Hootie81/Dual-DC-Motor/Dual DC Motor v1-0/DualDCMotor v1-0 BOM.xlsx

Hootie81's Dual DC Motor Controller Shield
Version 1.0
2014-08-02
Description | Qty | Value | Package | Designator | Manufacturer | Part Number
PCB | 1 | V1.0 | NA | NA | OSH Park | NA
IC Motor Driver | 1 | NA | 24-SSOP | U1 | Toshiba | TB6612FNG(O,C,8,EL)
SPI I/O Expander PWM | 1 | NA | 16-SSOP | U2 | Maxim | MAX6966AEE+
Capacitor Tantalum | 1 | 10uF 25v 10% | 1411 | C3 | Kemet | T491B106K025AT
Capacitor | 2 | 0.1uF 25v 10% | 603 | C1, C2 | Murata | GRM188R71E104KA01D
Resistor | 7 | 47k 0.25W 1% | 603 | R1 to R7 | Rohm Semiconductor | ESR03EZPJ473
SMT Header Pin | 1 | 2 x 2pin | 0.100" pitch | JP1 | FCI | 95278-101A04LF
SMT Header Socket | 1 | 2 x 2pin | 0.100" pitch | JP3 | TE Connectivity | 969973-2
Screw terminal | 1 | 6pin | 3.5mm pitch | X1 | Phoenix Contact | 1751280
