Hootie81/Dual-DC-Motor/Dual DC Motor v1-0/DualDCMotor v1-0.brd

## EAGLE design Dual DC Motor v1-0/DualDCMotor v1-0.brd (2014-07-28)

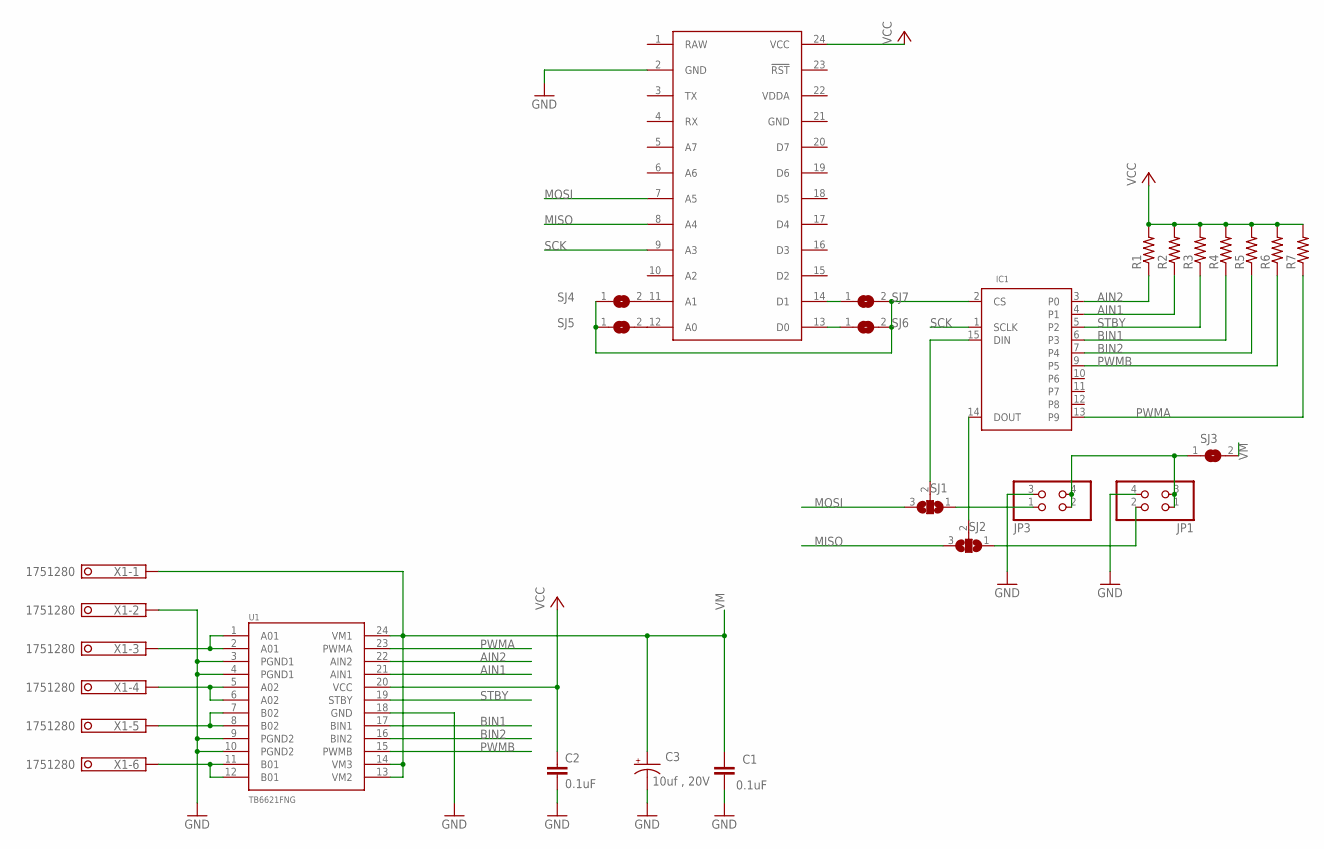
[picture p1: schematic DualDCMotor v1-0.sch]

Parts:
C1, C2: 0.1uF; 0402-CAP
C3: 10uf , 20V; EIA3528
IC1: MAX6966AEE; QSOP16
JP1, JP3: PINHD-2X02_2.54-SMD; 2X02SMD
R1, R2, R3, R4, R5, R6, R7: R-US_R0603; R0603
SJ1, SJ2: SJ2W; SJ_2
SJ3: SJW
SJ4, SJ5, SJ6, SJ7: SJ
U1: TB6621FNG; SSOP24
U$1: SPARK_CORECORE; SPARK_CORE
X1: 1751280

Connections:
A01: U1.1 (A01), U1.2 (A01), X1.3
A02: U1.5 (A02), U1.6 (A02), X1.4
AIN1: IC1.4 (P1), R2.1, U1.21 (AIN1)
AIN2: IC1.3 (P0), R1.1, U1.22 (AIN2)
B01: U1.11 (B01), U1.12 (B01), X1.6
B02: U1.7 (B02), U1.8 (B02), X1.5
BIN1: IC1.6 (P3), R4.1, U1.17 (BIN1)
BIN2: IC1.7 (P4), R5.1, U1.16 (BIN2)
GND: C1.2, C2.2, C3.C (-), IC1.8 (GND), JP1.4, JP3.3, U1.3 (PGND1), U1.4 (PGND1), U1.9 (PGND2), U1.10 (PGND2), U1.18 (GND), U$1.2 (GND), U$1.21 (GND), X1.2
MISO: SJ2.3, U$1.8 (A4)
MOSI: SJ1.3, U$1.7 (A5)
unnamed: JP3.1, SJ1.1
unnamed: JP1.2, SJ2.1
unnamed: IC1.15 (DIN), SJ1.2
unnamed: IC1.14 (DOUT), SJ2.2
unnamed: SJ4.2, U$1.11 (A1)
unnamed: SJ5.2, U$1.12 (A0)
unnamed: SJ6.1, U$1.13 (D0)
unnamed: SJ7.1, U$1.14 (D1)
unnamed: IC1.2 (CS), SJ4.1, SJ5.1, SJ6.2, SJ7.2
PWMA: IC1.13 (P9), R7.1, U1.23 (PWMA)
PWMB: IC1.9 (P5), R6.1, U1.15 (PWMB)
RAW: U$1.1 (RAW)
SCK: IC1.1 (SCLK), U$1.9 (A3)
STBY: IC1.5 (P2), R3.1, U1.19 (STBY)
VCC: C2.1, IC1.16 (VCC), R1.2, R2.2, R3.2, R4.2, R5.2, R6.2, R7.2, U1.20 (VCC), U$1.24 (VCC)
VDDA: U$1.22 (VDDA)
VM: C1.1, C3.A (+), SJ3.2, U1.13 (VM2), U1.14 (VM3), U1.24 (VM1), X1.1
VM2: JP1.1, JP1.3, JP3.2, JP3.4, SJ3.1

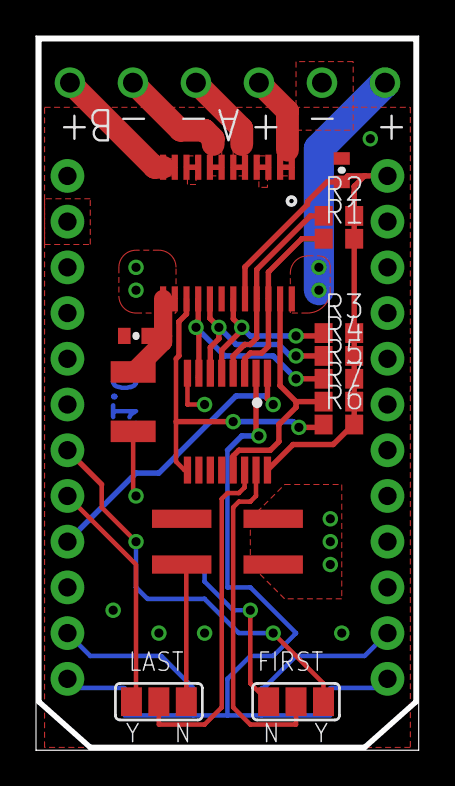
[picture p2: board DualDCMotor v1-0.brd from above]

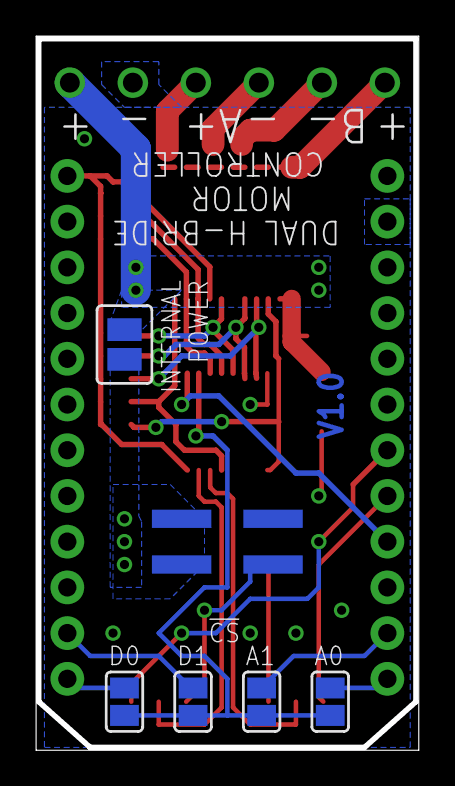
[picture p3: board DualDCMotor v1-0.brd from below]

Board: 2 copper layers, 21.3 x 39.7 mm, 23 parts (6 on the bottom side), 27 nets.
