Hootie81/Dual-DC-Motor/(commit log)

2014-07-26 Dual DC Motor shield for Spark Core
    A Shield for the spark core capable of driving 2 DC motors at 1.2A
    continuous and 3.2A peak. The board has a SPI interface with the Spark
    and allows a daisy-chain configuration where more of the same series of
    cards will not require any extra I/O , CS is selectable by
    solder-jumpers
    [DualDCMotor.brd, DualDCMotor.sch]
2014-07-28 Pullup resistors added
    Added pullup resistors to datalines between i/o expander and h-bridge
    Fixed silkscreen layers
    Added gerbers
    [DualDCMotor v1-0.brd, DualDCMotor v1-0.sch]
2014-08-01 Added Library
    Added a library to control the card, at this stage its untested and
    outputs the SPI data to the terminal window.
2014-08-02 Added BOM
    [DualDCMotor v1-0 BOM.xlsx]
2014-09-12 Cleanup
    Removed old versions to avoid confusion
    [DualDCMotor.brd, DualDCMotor.sch]
2014-10-09 Tested Library
    Working Library.
    Added stepper motor support.
